SurasakNie/naodec/firmware/media_playback_controller/README.md

# Media Playback Controller Firmware

Arduino-IDE sketch for the NaoDec Media Playback Controller — an ESP32-S3-DevKitC-1
operator panel (rotary volume encoder + Play/Pause/Stop buttons + network status LED)
that sends OSC-over-UDP transport/volume commands to a Max/MSP patch. It carries no
audio, video, or LED data/power.

Firmware 3.x targets hardware **Rev 3.0**, which reaches the LAN over **wired
Ethernet** — U2, a WIZnet W5500 Lite SPI module — instead of Wi-Fi; see
[`NaoDec_Media_Playback_Controller_Rev3_Ethernet_Rationale.md`](../../NaoDec_Media_Playback_Controller_Rev3_Ethernet_Rationale.md)
for why.

**FW 3.1.x adds an optional Wi-Fi fallback** on the same Rev 3.0 hardware (no
schematic change). Wired Ethernet stays primary; if the Ethernet link drops and
stays down, and Wi-Fi credentials have been stored, the controller brings up a
Wi-Fi station and keeps sending OSC over it. Ethernet always wins — the moment
the cable link and DHCP lease return, the radio is switched back off. With no
credentials stored the board is wired-only, identical to FW 3.0.

The firmware version tracks the schematic revision it targets, with the minor
digit bumping for firmware feature releases on that hardware (FW 3.0.x =
Ethernet only; FW 3.1.x = Ethernet + Wi-Fi fallback; both ↔ Schematic Rev 3.0).
The patch digit is for firmware-only fixes on the same feature set:
- **FW 3.1.1** enables the ESP32's internal weak pull-ups on the encoder `A`/`B`
  pins (GPIO7/8), so those lines idle high even if a fitted KY-040 clone lacks
  its own onboard pull-ups. It touches no other pin.
- **FW 3.1.2** treats the three transport buttons as mutually exclusive: if two
  press edges arrive in the same debounce instant (impossible from a human on
  separate panel switches, but exactly what a GPIO9↔GPIO10 short produces), the
  event is rejected and logged as a `[FAULT]` instead of emitting a wrong
  transport command. See the Play/Pause note below — this is a guard and a
  diagnostic, **not** a substitute for clearing the short.

Full hardware assembly, wiring, network setup, and acceptance tests:
[`NaoDec_Media_Playback_Controller_Build_and_Max_Setup.md`](../../NaoDec_Media_Playback_Controller_Build_and_Max_Setup.md)
(Rev 3.0). Schematic: [`NaoDec_Media_Playback_Controller_Schematic_Rev3.0.html`](../../NaoDec_Media_Playback_Controller_Schematic_Rev3.0.html).

> **Note:** the Build & Max Setup document is still at Rev 3.0 and describes
> Ethernet-only behavior. The Wi-Fi fallback below is a firmware feature pending
> bench testing; that document will be revised to Rev 3.1 as a follow-up.

## Build requirements

- Arduino IDE with the **esp32 by Espressif Systems** board package **version
  3.0.0 or newer** (Boards Manager) — W5500 support lives in the core's `ETH.h`.
  If the build fails with `ETH_PHY_W5500` undeclared, the installed core is
  2.x; update it.
- **No third-party libraries.** The Wi-Fi fallback uses the core's own `WiFi.h`;
  the FW 1.x WiFiManager dependency is still gone and can be uninstalled.
- Board setting: **ESP32S3 Dev Module**, matching the ESP32-S3-DevKitC-1 board
  (N8R8 or N16R8 per the Build doc BOM).

Command-line compile check, if you use arduino-cli:

```bash
arduino-cli compile --fqbn esp32:esp32:esp32s3:CDCOnBoot=cdc firmware/media_playback_controller
```

## Network setup (Ethernet / DHCP reservation)

There is nothing to provision on the board — no SSID, no password, no captive
portal. The controller DHCPs over the wired link and the router hands it its
reserved address.

1. Connect the W5500's RJ45 to an ASUS RT-AX1800HP LAN port with the ~6 m Cat6
   run (W2 in the Build doc BOM).
2. Flash the firmware, open the Serial Monitor at 115200 baud, and type
   `STATUS`. Copy the `MAC (ETH)` line. **The Ethernet MAC is not the same as
   the old Wi-Fi MAC** — a DHCP reservation created for FW 1.x will not match
   this interface.
3. On the router, under LAN → DHCP Server → Manually Assigned IP, replace the
   old Wi-Fi-MAC entry with the Ethernet MAC at `192.168.50.114` (the `.11x`
   convention from Build doc Section 8).
4. Replug the cable (or power-cycle). `STATUS` should now show
   `IP address: 192.168.50.114`; confirm with `ping 192.168.50.114` and
   `ping naodec-playback.local` (mDNS).

The board is safe to boot with the cable unplugged: the status LED blinks at
~2 Hz until link + DHCP lease, then goes solid. If the reservation is missing,
the panel still works (OSC is outbound-only) — it just leases a pool address
(`192.168.50.100`–`199`), visible via `STATUS`.

## Wi-Fi fallback (optional, FW 3.1+)

Wired Ethernet stays primary and needs no provisioning. The Wi-Fi fallback is
opt-in — store credentials only if you want the panel to keep working when the
cable/router link is lost.

1. With the board flashed and the Serial Monitor open at 115200 baud, type
   `SETWIFI <ssid> <password>`. The SSID must not contain spaces; everything
   after the first space is taken as the password (so the password may contain
   spaces). Credentials are saved to NVS and never printed back or stored in the
   sketch.
2. `STATUS` now shows the stored SSID (never the password) and the **Wi-Fi MAC**,
   which differs from the Ethernet MAC. If you want the fallback to land on a
   fixed address too, add a *second* router DHCP reservation keyed to that Wi-Fi
   MAC (e.g. `192.168.50.115`). Otherwise it leases a pool address.
3. Behavior: only after Ethernet has been down continuously for ~15 s does the
   radio come up; the moment Ethernet regains its link + lease, the radio is
   switched back off. The OSC contract (addresses, port `9000`, target
   `192.168.50.2`) is identical on either interface.

To go back to wired-only, type `RESETWIFI` — it clears the stored credentials
and turns the radio off.

> mDNS (`naodec-playback.local`) is advertised for the interface active at boot;
> when running on the Wi-Fi fallback, reach the panel by its IP (from `STATUS`)
> if the `.local` name does not resolve. OSC itself always targets `MAX_HOST` by
> IP, so playback control is unaffected either way.

## Serial commands (USB, 115200 baud)

| Command | Effect |
|---|---|
| `STATUS` | Prints firmware version, active interface, Ethernet link state/speed + IP + MAC, Wi-Fi SSID/MAC/IP/RSSI (when credentials are stored), hostname, OSC target, current volume, and uptime. |
| `SETWIFI <ssid> <password>` | Stores Wi-Fi fallback credentials in NVS (SSID must not contain spaces; the rest of the line is the password). Enables the fallback path. |
| `RESETWIFI` | Clears the stored Wi-Fi credentials and turns the radio off — reverts to wired-only. |

## Configuration

`MAX_HOST` (`192.168.50.2`) and `OSC_PORT` (`9000`) are `#define`s at the top of
the `.ino`, matching the network plan in Build doc Section 8. These aren't
secrets — they're already published in that document. Wi-Fi credentials are the
one real secret, and they are never in the sketch: `SETWIFI` stores them in NVS
at runtime, so nothing sensitive is committed to this (public) repo.

The Ethernet-down grace period and the Wi-Fi retry cadence are the
`ETH_FALLBACK_MS` / `WIFI_RETRY_MS` `#define`s (both 15 s by default).

W5500 wiring is fixed by Schematic Rev 3.0 and mirrored by the `PIN_ETH_*`
defines:

| W5500 signal | ESP32-S3 GPIO |
|---|---|
| SCLK | 13 |
| MOSI | 14 |
| MISO | 15 |
| SCS (CS) | 16 |
| INT | 17 |
| RST | 18 |

`ETH_SPI_MHZ_W5500` (default 20 MHz) can be dropped to 10–16 if a jumper-wired
bench module shows SPI errors. If a bench build leaves INT unwired, polled mode
(`irq = -1`) requires esp32 core 3.1 or newer.

If the encoder direction comes out backwards on the bench (Build doc Section 9
troubleshooting table), flip `ENCODER_REVERSED` to `1` instead of re-wiring A/B.

If FUNC-05/06 show about half the expected step (ten detents move volume ~10
points instead of ~20), the fitted encoder emits two quadrature transitions per
detent rather than four — set `ENCODER_STEPS_PER_DETENT` to `2`.

`PIN_ENC_A`/`PIN_ENC_B` are configured `INPUT_PULLUP` (FW 3.1.1+) rather than
plain `INPUT`. The NEBDS-01's Schmitt push-pull output is unaffected by the
added internal pull-up; a bare KY-040 clone with no onboard CLK/DT pull-ups
now still idles high instead of floating. `R1`/`R2` (external 10 kOhm) remain
DNP by default per Build doc Section 3 — only populate them if encoder
misreads persist after this firmware change.

> This pull-up change is unrelated to Play/Pause/Stop: those buttons (GPIO9-11)
> were already `INPUT_PULLUP` and are untouched by FW 3.1.1.

### Play/Pause cross-trigger (one button fires two commands)

If pressing Play also fires Pause (or vice-versa), the root cause is a **short
between the adjacent button GPIOs — GPIO9 (Play) and GPIO10 (Pause)**, which sit
next to each other on the DevKitC-1 header. When bridged (solder whisker, stray
strand, pinched harness) both lines pull LOW together, so one physical press
reads as two. The audit ruled out the other layers:

- **Firmware button logic** debounces each pin independently — no cross-coupling.
- **Max test patch** routes `/transport/play` and `/transport/pause` through
  separate `OSC-route` objects with no cross-wire — verified in
  `TransportReceiveTest1.maxpat`.

So a firmware/patch change cannot *cure* a hard short — both pins read the same
value. What FW 3.1.2 does is **detect and contain** it: two simultaneous edges
are rejected with a `[FAULT] Simultaneous transport inputs …` log line that
names the suspect pins, turning a confusing phantom-Pause into an obvious,
logged fault. The fix itself is hardware: power off and run the **GPIO9↔GPIO10
continuity check** in Build doc Section 10 (≈0 Ω = header/PCB bridge; ≈200 Ω =
panel-side harness short; ≈20 kΩ = healthy).

> **Max patch note:** the bundled `TransportReceiveTest1.maxpat` had its Stop
> route mis-cased as `/transport/Stop/`, which never matched the firmware's
> lowercase `/transport/stop`; it is corrected to `/transport/stop/` so all four
> routes match. (Unrelated to the Play/Pause short, but found in the same audit.)

## Status LED

| LED state | Meaning |
|---|---|
| Solid on | Ethernet link up with a DHCP lease — normal operation |
| Mostly on, brief off-blip every ~2 s | Running on Wi-Fi fallback — panel works, but the wired link is down and needs attention |
| Blinking ~2 Hz | No network on either interface (check cable, router port, DHCP; Wi-Fi not connected) |
| Off | No power (or firmware fault) |

## Validating before installation

This firmware implements the behavior table in Build doc Section 6 and the OSC
contract in Section 7. Before calling a built unit ready, run the full
acceptance test list in Section 11 — the network tests are exercised with the
Ethernet cable (unplug/replug) rather than the router's Wi-Fi radio — and fill
out the Section 12 commissioning record, including the `FW_VERSION` string this
firmware prints at boot as the "Firmware version" field.
