SurasakNie/naodec/Paint_Comparison_Maxzo_RustTech_vs_JBP_SmartGlaze.md

# Paint Comparison for Wood Work: Maxzo Rust Tech 2IN1 #8300 vs. JBP Smart Glaze (Ultra Gloss Enamel & 2IN1)

Reference notes comparing three commercially available oil/alkyd-type coatings for painting wood
(and mixed wood + metal builds), with cautions specific to wood application.

## Products covered

1. **Maxzo Rust Tech 2IN1 #8300** — matte black, combines anti-rust primer + topcoat in one product.
   Primary use case is metal (steel, galvanized steel, zinc-plated steel, aluminum, stainless steel);
   the label also lists plywood, wood siding board, and all types of artificial/composite wood as
   compatible surfaces — solid/hardwood is not listed.
2. **JBP Smart Glaze Ultra Gloss Enamel** — oil-based alkyd resin gloss enamel, topcoat only (no
   built-in primer). Labeled for both wood and metal (doors, windows, furniture, machinery).
3. **JBP Smart Glaze 2IN1** — acrylic-resin based, combines anti-rust primer + topcoat in one
   product, explicitly labeled for metal, non-metal, and wood surfaces, interior and exterior.

## Comparison table

| Consideration | Maxzo Rust Tech 2IN1 #8300 (matte) | JBP Smart Glaze Ultra Gloss (gloss) | JBP Smart Glaze 2IN1 (gloss) |
|---|---|---|---|
| Formula type | 2-in-1 anti-rust primer + topcoat | Topcoat only (alkyd) | 2-in-1 anti-rust primer + topcoat (acrylic) |
| Labeled for use on wood | ❌ (primary formula target is metal) | ✅ (wood & metal: doors, furniture) | ✅ (metal, non-metal, and wood — explicit) |
| Usable on plywood / siding board / composite wood | ✅ | ✅ | ✅ |
| Usable on solid/hardwood per label | ❌ (not listed — test a small area first) | ✅ | ✅ |
| Built-in primer (no separate primer coat needed) | ✅ | ❌ (bare wood should be primed/sealed first) | ✅ |
| Rated for exterior use (sun/rain exposure) | ✅ | ✅ | ✅ |
| Impact / scratch resistance per label | ✅ (explicitly stated) | ⚠️ (not explicitly stated, but typical for alkyd gloss) | ⚠️ (not explicitly stated) |
| Anti-fungal / anti-algae | ⚠️ (not stated) | ✅ (explicitly stated) | ⚠️ (not stated) |
| Lead/mercury-free (stated on label) | ⚠️ (not stated) | ✅ (explicitly stated) | ⚠️ (not stated) |
| Finish hides surface imperfections in wood | ✅ (matte) | ❌ (gloss shows flaws — sand smooth first) | ❌ (gloss shows flaws — sand smooth first) |
| Fewer work steps / faster overall job | ✅ (single coat system) | ❌ (needs separate primer + topcoat, ≥2–3 passes) | ✅ (single coat system) |
| Fast drying | ✅ (headline feature) | ❌ (surface dry 30 min–4 hr / recoat 4–8 hr / full cure 48 hr+) | ⚠️ ("fast drying" claimed; touch-dry ~30 min, but recoat still 4–8 hr) |
| Required thinner | AAA thinner only (never turpentine/mineral spirit substitute) | JBP T-317 or AAA thinner | JBP T-317 or AAA thinner |
| Coverage per gallon per coat | ⚠️ (no confirmed figure found) | ✅ 30–40 m² | ✅ 30–40 m² |
| Long-term gloss/color retention (as a selling point) | ❌ (matte finish, not the focus) | ✅ (headline feature of this line) | ⚠️ (glossy, but retention isn't emphasized as strongly) |
| Best fit for mixed wood + metal builds in one pass | ✅ | ❌ | ✅✅ (only 2-in-1 in this table explicitly rated for wood) |

Legend: ✅ suitable/confirmed · ❌ not suitable/not confirmed for this use · ⚠️ usable with caveats, or unconfirmed by the manufacturer listing.

## Cautions when painting wood

- **Maxzo Rust Tech** is formulated first for rust prevention on metal. Its wood compatibility on
  the label is limited to plywood/siding/composite wood — not solid wood. The rigid rust-inhibitive
  film is not designed to flex with wood's moisture-driven expansion/contraction, so it may be more
  prone to cracking along the grain on solid wood over time. Test on a small area first.
- **JBP Smart Glaze Ultra Gloss Enamel** is a topcoat only — bare wood should get a wood primer/
  sealer coat first, otherwise the oil-based enamel absorbs unevenly into porous wood (knots, end
  grain), producing a patchy sheen and wasting material.
- **Drying times matter for scheduling.** JBP Ultra Gloss: touch-dry in 30 min–4 hr, recoat window
  4–8 hr, full/hard cure 48 hr+. Don't load or stack painted pieces before full cure, and protect
  the work from dust, insects, and rain throughout the cure period. Recoating outside the 4–8 hr
  window (i.e., after the film has hardened too much) needs a light sanding pass first for proper
  intercoat adhesion; recoating too early (before the lower coat has released enough solvent) risks
  wrinkling/lifting.
- **Use only the manufacturer-specified thinner** — Maxzo requires AAA thinner and explicitly warns
  against turpentine; using the wrong solvent affects film adhesion and finish.
- **Gloss vs. matte surface prep**: gloss finishes (both JBP products) show surface defects clearly,
  so sand and fill wood before coating. Matte (Maxzo) is more forgiving of surface texture.
- **Don't casually layer products from different lines** (e.g., a Maxzo matte base under a JBP gloss
  topcoat) without a test patch — different alkyd/acrylic formulations and solvent strengths can
  cause poor intercoat adhesion or wrinkling if recoat timing isn't respected.
- **Solvent-based safety**: all three products are flammable while wet, need good ventilation, and
  require PPE (gloves, respirator) during application. Oil-soaked rags carry a spontaneous
  combustion risk — lay them flat to dry outdoors or submerge in water before disposal; never bunch
  them into a trash bin.
- **Label mix-up risk**: JBP sells both "Smart Glaze Ultra Gloss Enamel" (topcoat only) and "Smart
  Glaze 2IN1" (primer + topcoat) under similar names — confirm "2IN1" is on the label if a
  self-priming product is what's needed.
- Neither Maxzo nor JBP 2IN1 states anti-fungal/anti-algae or lead/mercury-free properties on their
  listings (unlike JBP Ultra Gloss, which states both) — verify on the physical can label if this
  matters for the application (e.g., children's furniture).

## Sources

- [Maxzo Rust Tech (MATT) — chosanguan.com](https://chosanguan.com/products/588-maxzo-rust-tech-matt-แมกโซ่-รัสท์เทค-สีทาเหล็ก-2-in-1.html)
- [TDS Maxzo Rust Tech 2 IN 1 — srrpaint.co.th (PDF)](https://www.srrpaint.co.th/filesdirectserver/itp1/98c8b34845583eba/TDS-Rusttech-DATA-mattz-z687914991456.pdf)
- [JBP Smart Glaze Ultra Gloss Enamel — jbp.co.th](https://jbp.co.th/product/jbp-smart-glaze/)
- [JBP Smart Glaze Enamel Paint 2IN1 — jbp.co.th](https://jbp.co.th/product/jbp-smart-glaze-enamel-paint-2in1/)
- [JBP Smart Glaze 2IN1 — Thaiwatsadu](https://www.thaiwatsadu.com/th/product/สีทับหน้าและรองพื้นกันสนิม-ชนิดเงา-JBP-รุ่น-SMART-GLAZE-2IN1-ขนาด-1-แกลลอน-สีเงิน-G7114-60418537)
- [JBP Smart Glaze 2IN1 — HomePro](https://www.homepro.co.th/p/1272393)
- [JBP Smart Glaze Ultra Gloss Enamel — Kasem Paint Depot](https://www.kasempaintdepot.com/product-page/ส-น-ำม-นเจบ-พ-สมาร-ทเกรซ-jbp-smart-glaze-แกลลอน)
