SurasakNie/naodec/NaoDec_Build_Step7_Edge_Covers.md

# NaoDec Build — Step 7: Edge Covers

**Revision:** 1.0
**Date:** 2026-07-14
**Status:** Drafted from the author's outline + decision 9⑤. Cover material, profile, and fixing method are TBD (see Open Items).

[← Back to Build Work Instructions](NaoDec_Build_Work_Instructions.md) · Previous: [Step 6 — Move-In](NaoDec_Build_Step6_Move_In.md) · Next: [Step 8 — Controller Unit Hookup](NaoDec_Build_Step8_Controller_Unit_Hookup.md)

## Purpose

Fit the **25 external edge covers** over the 25 lettered joints, closing out the structure's outside seams. The 5 ground-resting edges get no cover.

## Quick Reference

| Fact | Value |
|---|---|
| Covers | **25 pieces** — one per lettered joint (A–Z, no `W`) |
| No cover on | the 5 unlettered ground edges (`f7`–`f11` base edges) |
| Per joint, on that edge | 2 hinges (Step 2) + internal LED strip (Step 4) + on joint M a speaker (Step 5) + this cover |
| Door joints | A, B, K, L — covers here must not block the door mechanism |
| Top joints | U, V, X, Y, Z — overhead work |

The 25 lettered joints (from the marking guides): A B C D E F G H I J K L M N O P Q R S T U V X Y Z.

## 7.1 Fit the covers

1. Fit each cover over the **outside** of its lettered joint — the LED strips run on the inside (Step 4), so covers and strips are on opposite faces of the edge.
2. Each cover must **clear the 2 hinges** on that joint and any speaker/bracket hardware (joint M) — profile has to bridge or notch around them (Open Item #1).
3. Work bottom-up so offcuts/tools don't fall onto finished lower work; leave the **5 top joints (U, V, X, Y, Z) for last** — overhead work.
4. **Door joints A, B, K, L:** fit so the door still opens per the Step 2 mechanism decision — a cover spanning the door's hinge line or latch side can lock it shut (Open Item #3).

> The covers hide the assembly letters. Since the marking system exists for teardown/re-assembly, record each cover's joint letter **on the cover itself** (inside face) or keep a teardown map, so letters stay findable later (Open Item #2).

## Safety

- Overhead work for the top joints — positive fastening, nothing relying on friction over the occupant.
- Ladder work inside/outside the closed structure; the chair and equipment are now in place (Step 6), so protect them below the work.

## Release Gate

| Gate | Required Result |
|---|---|
| Count | 25 covers fitted, one per lettered joint; ground edges bare |
| Clearance | Each cover clears its hinges + hardware; no fabric pinch |
| Door | Door joints' covers do not impede opening/closing from inside |
| Teardown | Joint letters recorded on/with each cover |

## Open Items

1. **Cover material / profile / fixing method** — screwed, clipped, magnetic, snap-fit? Must span/notch the 2 hinges (+ speaker on M). TBD.
2. **Removability for teardown** — covers + hinges must come apart for repeat assembly (index Open Item #5); letters stay findable.
3. **Door-edge covers vs. door swing** — depends on the door mechanism (Step 2 Open Item #1).
4. **Function of the covers** — purely cosmetic edge trim, or do they also seal the fabric edges against light leak / weather? Not stated; affects material choice.

---

[← Back to Build Work Instructions](NaoDec_Build_Work_Instructions.md) · Previous: [Step 6 — Move-In](NaoDec_Build_Step6_Move_In.md) · Next: [Step 8 — Controller Unit Hookup](NaoDec_Build_Step8_Controller_Unit_Hookup.md)
