SurasakNie/naodec/(commit log)

2026-04-24 Initial NaoDec repo: wiring and schematics + auto-index workflow
2026-04-28 feat: publish Rev1.2 / Rev1.1 / Rev1.6, remove Rev1.1 / Rev1.0 / Rev1.5
    Replaces NaoDec_3D_Internal_Edges_LED_Mapping_Rev1.1 → Rev1.2,
    NaoDec_3D_Vertex_LED_Mapping_Rev1.0 → Rev1.1,
    NaoDec_WS2815_LED_Controller_Rev1.5 → Rev1.6.
    Simple_WS2815_Controller_Rev_1.0 unchanged. The auto-index workflow
    will regenerate index.html on push.
2026-05-15 Rename NaoDec Scent Controller - Schematic Rev 1.0.html to NaoDec_Scent-Controller_Schematic_Rev1.0.html
2026-06-16 Add Series Coil / Electromagnet subsystem docs (#2)
    Adds NaoDec_Series_Coil_Build_Rev1.0.html (self-contained page with two
    inline-SVG wiring figures, electrical tables, BOM, and safety checklist) and a
    matching README section with Mermaid diagrams.
    Key facts captured: on DC the 60-coil string is a ~3 ohm resistive near-short
    (no current limiter) drawing ~3-4 A / ~47 W; at ~4 A common JSTs are over
    rating so VH/Anderson + a 3-5 A fuse + a current-limited supply are needed; the
    crystal core is non-magnetic so the field stays weak (~28 AT/coil).
    https://claude.ai/code/session_01WWxNKYQzr3pKRn3qgcNeEq
2026-06-16 Archive Scent Controller schematic Rev1.0 (#3)
    Moves the superseded NaoDec_Scent_Controller_Schematic_Rev1.0.html into
    Archived/ (Rev2.0 remains the current top-level version). Pure file move;
    index.html regenerates on main and drops Rev1.0 from the index.
    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
2026-06-17 Add Controller Box Configurations diagram Rev1.0
    Interactive HTML showing both enclosure options (electrical DIN-rail box
    and PC case + ATX PSU) with component layout, power routing, mid-strip
    injection wiring, and a comparison table.
    https://claude.ai/code/session_01X5VjzeCp9amFkY88mgiwpq
2026-06-17 Audit and correct power calculations in controller box configs (Rev1.1)
    Seven calculation errors corrected vs Rev1.0:
    - Cable resistance was off by 3.28× (Ω/1000ft used as mΩ/m)
    - Strip #1 18AWG 20m V-drop: 230mV → 754mV (strip input 11.77→11.25V)
    - Edge head-feed 12AWG 4m V-drop: 53mV → 175mV
    - In-strip injection drops: 329mV first-half corrected to 188mV; end-voltage
    labelled as estimate (typ. 60mΩ/m trace — measure to confirm)
    - Removed fabricated "53.4A worst-case" (no basis in source schematics)
    - Edges total: 26.6A (15.8mA/px) → 25.2A (15mA/px per source schematic)
    - 12V rail total: 27.3/28.7A (inconsistent) → 27.1A everywhere
    - Scent ESP current: 0.58A → 0.40A; tot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
2026-06-17 Add full power & controller box report (Rev 1.0)
    Consolidates all audited figures into one reference document:
    - Device-by-device power inventory (verified against both schematics)
    - PSU requirements for all 4 rails with margins
    - Config 1 (DIN-rail enclosure) and Config 2 (ATX case) specifications
    - Cable voltage-drop analysis with corrected mΩ/m resistances
    - Mid-strip injection layout for 6 edge strips
    - ATX PSU shortlist (10 units)
    - Full audit findings table (13 corrections, Rev1.0 → Rev1.1)
    - Open items requiring physical measurement or user decision
    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
2026-06-17 Add html-schematic org skill (v4.0.0) as a project skill
    Vendor the Hubble Engineering html-schematic skill into
    .claude/skills/html-schematic/ so /html-schematic is available to Claude
    Code sessions on this repo — which is built around the exact
    SVG/zoom/pan/tooltip HTML schematics this skill generates.
    Contents: SKILL.md, reference/ (conventions, tables, tokens,
    validator-spec, 8 theme palettes), snippets/, skeleton.html.
    Intentionally omits the skill's bundled .claude/ packaging files
    (launch.json, settings.local.json): they are the author's local Windows
    build/zip tooling with hardcoded personal paths, are not read by Claude
    Code from inside a nested skill folder, and settings.local.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
2026-06-17 Rename Series Coil build to Rev 0 — pre-release
    Demote NaoDec_Series_Coil_Build from Rev 1.0 to Rev 0 (pre-release):
    rename the HTML file and update its title/subtitle/footer, plus the
    README repo tree, write-up link, and revisions table, and the
    auto-index entry.
    Add CLAUDE.md recording the pre-release status and project conventions
    (filename versioning, auto-generated index, isolated power rails).
    Claude-Session: https://claude.ai/code/session_01SA58jxHXGFS1beMYw1qYmc
2026-06-17 Add project CLAUDE.md with Wire Assignment Table (Dark Teal palette)
    Locks the html-schematic skill's VR9 net-color allocation to NaoDec's
    real harness: maps wdata..wdata7 to CH1..CH7 using the existing
    Rev-series Dark Teal hex palette, so skill-generated/revised schematics
    stay color-consistent with the current rig docs.
    Net-IDs (CH1..CH7) and per-channel hex are taken from
    NaoDec_WS2815_LED_Controller_Rev1.6.html; the channel/GPIO/strip/LED
    mapping is from the README. Power-rail tokens documented for reference.
    The table is in the exact 3-column format the skill's validator parses
    under a "Wire Assignment Table" heading.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
2026-06-17 Add CC/CV buck (~3 A) as recommended current limiter
    Document a CC/CV buck converter with the constant-current limit set to
    ~3 A as the cheap, enclosure-friendly hard current limit for the series-
    coil near-short: add a BOM row, a "Recommended supply" option, and a
    mention in the safety checklist. Note that into the ~3 Ω load it sits in
    CC and the output self-settles to ~9 V.
    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
2026-06-17 Fix VR9/VR7 finding: tag backup-ground wires as a ground rail (Rev1.6)
    The 7 "Head BI -> GND" backup-input polylines used a custom `.wbkp-gnd`
    class the html-schematic validator doesn't recognize as a rail, which
    tripped VR9 (net-color table) and VR7 (legend strip). Prepend the
    recognized `wgnd` rail class: class="wgnd wbkp-gnd".
    Zero visual change: `.wbkp-gnd` is declared after `.wgnd`, so its
    stroke-width:2 still wins the cascade; the validator now reads the first
    class `wgnd` as a ground rail. Backup-ground semantics stay intact via
    the retained `.wbkp-gnd` class and each wire's data-info. Also makes
    these wires pick up print-mode ground coloring.
    No revision bump or file rename: this i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
2026-06-17 Reconcile PR #4 (CC buck / input fuse / paralleled-SM) onto Rev 0 — pre-release
    Fold the chosen power-protection design from PR #4 into the renamed Series
    Coil document under our Rev 0 — pre-release identity. PR #4 kept Rev 1.0;
    this keeps the rename and the Rev 0 — pre-release labels instead.
    - BOM: JST SM connectors (both pins paralleled), 12 V PSU feeding the buck,
    CC/CV buck module (XL4015, CC ~3 A) as the current limiter, input-side
    fuse re-justified (buck CC is regulation not fault protection; bucks fail
    shorted).
    - New "Recommended solution" section + "why this works" callout; safety
    checklist updated to the buck-based solution.
    - Mirror the same into README (BOM, elect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
2026-06-17 Show the XL4015 CC/CV buck inline in Figure 1 (loop topology)
    Redraw the Series Coil topology diagram as PSU → fuse → CC/CV buck
    (XL4015, CC ~3 A) → 20 groups → 6 m return, so the figure matches the
    recommended solution. The buck is now drawn as the current limiter and
    the caption no longer claims "no current-limiting element other than
    wire resistance and the supply."
    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
2026-06-17 Spell out fuse placement: before the XL4015, not after
    Approved design decision — the input-side fuse is the only position that
    contains input-stage and buck-internal shorts (input cap, FET-to-ground,
    shorted output cap); an output-side fuse is blind to them. Make the
    before-not-after rationale explicit in the Recommended solution section.
    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
2026-06-19 Series Coil: record bench-verified XL4015 operating point (11.68 V / 2.75 A)
    The XL4015 CC/CV buck is already documented as the current limiter. Add the
    measured bench result alongside the predicted numbers: the string runs at
    11.68 V / 2.75 A (~32 W) at the buck output, implying a real loop of ~4.3 ohm
    (a little above the ~3 ohm estimate), so current settles just under the 3 A cap
    — sitting at the CV/CC knee rather than deep in CC.
    Updates the HTML recommended-solution and BOM sections plus the README BOM and
    electrical-summary tables; refreshes the in-page date. Connector and other
    guidance unchanged.
    Claude-Session: https://cla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
2026-06-19 Add Media Playback Controller schematic Rev 1.0
2026-06-19 Update PSU connection to 5V pin instead of USB-C
    Changed Media Playback Controller schematic to route PSU power directly to the
    5V pin rather than through USB-C, improving clarity on the intended power path.
    Claude-Session: https://claude.ai/code/session_01EqEs5bzcng2fjiRZzaTxwB
2026-06-19 Add Rev1.3: Series Coil Circuit display layer
    - New Coil toggle in Display panel: red positive daisy-chain (0→v1→…→v20) and dark-blue negative return (v20→v16→v15→v6→v5→v1→0)
    - Shared-edge parallel lines: red stays on edge, blue offset beside it
    - Coil view forces vertex node labels visible
    - Summary moved to its own left-panel tab (Routing · Summary · Revisions)
    - Rev1.2 kept live alongside Rev1.3; both listed in index.html and README.md
2026-06-19 Add Vertex series coil schematic
2026-06-19 Fix schematic UTF-8 encoding
2026-07-01 Update media playback encoder module schematic
2026-07-01 Align Media Playback Controller network setup with real ASUS LAN
    Replace placeholder Max/controller IPs with the actual NaoDec router
    config: gateway 192.168.50.1, Mac Mini static 192.168.50.2, and
    192.168.50.114 reserved for this controller per the .11x ESP32
    addressing convention. Credentials are referenced, not embedded.
2026-07-01 Document KY-040 encoder replacement option
2026-07-02 Fix cross-references and metadata for Media Playback Controller docs
    - Build doc: correct schematic filename reference (was missing NaoDec_
    prefix, 404 on Pages), bump to Rev 1.1 / 2026-07-02 with a change note
    for the network alignment
    - Schematic: note 1 now points to build doc section 7 (OSC contract),
    not the wrong "Section 2"
    - README: list both Media Playback Controller files in the repo tree
2026-07-02 Rev 2.0: harden Media Playback Controller design
    New NaoDec_Media_Playback_Controller_Schematic_Rev2.0.html (Rev 1.0
    kept in place for reference) and build doc bumped to Rev 2.0:
    - LED1 Wi-Fi status indicator on GPIO12 via R11 330 ohm
    (solid = connected, blink = reconnecting, off = no power)
    - R6-R10 100 ohm series resistors on all off-board GPIO lines
    (ESD/short protection + edge damping)
    - H1 keyed JST-XH 5-pin encoder connector (mis-plug-proof);
    H2-H5 2-pin for buttons and LED
    - Encoder shaft/frame-to-GND continuity added to build steps,
    electrical checks (new ELEC-03), and acceptance tests (FUNC-09)
    - USB-C cable spec tightened to quality cable <= 1 m
    README tree and index.html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
2026-07-02 Rev 2.1: require U1 co-located with operator panel; label R/C designators
    - Build doc: new Placement Requirement (Section 1) explaining why U1 must
    mount inside the operator panel enclosure rather than near the router —
    the panel wiring is unbuffered 3.3V logic rated for ~0.5 m runs, and
    Wi-Fi (not router proximity) already covers the long distance leg.
    Reinforced in the build steps and ASUS router setup section.
    - Schematic Rev 2.0: every R/C component box now shows its designator
    before the value (e.g. "R6 · 100", "C3 · 100n") instead of value only.
    Boxes were resized to fit and all connecting wire endpoints were
    updated to match; verified no clearance violations or text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
2026-07-02 Rev 2.2: document R1/R2/C1/C2 fallback values; add DOCX copy
    - Build doc: new "R1/R2/C1/C2 Fallback (Troubleshooting Reference)"
    section under the encoder documentation. Records that these four
    parts stay unpopulated by default on both encoder modules, and are
    only fitted (10 kOhm / 100 nF, matching the button RC values) if the
    KY-040 shows encoder misreads that firmware filtering doesn't resolve.
    - Add NaoDec_Media_Playback_Controller_Build_and_Max_Setup.docx, a Word
    rendering of the build doc for readers who prefer/require .docx.
    Generated with pandoc; tables, headings, and code blocks verified.
    - README and index.html list the new .docx.
2026-07-05 Add ESP32-S3 firmware for the Media Playback Controller
    Implements the Build_and_Max_Setup.md (Rev 2.2) spec: rotary encoder ->
    volume OSC, three transport buttons, Wi-Fi status LED, NVS-persisted
    volume, and OSC-over-UDP to Max/MSP. Architecture and coding conventions
    (WiFiManager captive-portal provisioning, RESETWIFI serial command,
    tagged Serial logging, boot-safe output state) are adapted from the
    existing Aroma/Scent Controller firmware.
    Claude-Session: https://claude.ai/code/session_011PV83pLjkTpQP19wt9Sddp
2026-07-07 Bump Media Playback Controller schematic to Rev2.2
    Aligns the schematic file with the build doc, which was already at
    Revision 2.2 while the schematic HTML itself never advanced past 2.0.
    Placeholder metadata bump only (title, title-block, revision history) —
    no electrical/BOM changes — to give a clean starting point for the
    upcoming PCB layout project. Rev2.0 moves to Archived/ per repo
    convention; Rev1.0 stays at top level as previously documented.
2026-07-07 Harden Media Playback Controller firmware from post-merge audit
    Fixes found in a two-pass audit of the merged firmware:
    - HIGH: bound the WiFiManager captive portal with a 180 s timeout so a
    power-up while the router is down no longer strands the panel in the
    portal forever; autoConnect() now returns and the device restarts to
    retry the saved network (fixes the NET-04 reboot case).
    - MEDIUM: sample the button pins in begin() so a button held or a harness
    shorted at boot no longer registers a phantom press and sends a transport
    command (fixes the FUNC-08 boot rule).
    - MEDIUM: blink the status LED via a Ticker while autoConnect() blocks, so a
    dark LED reliably means "no power / fa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
2026-07-08 Copy media_playback_controller firmware from main
    Brings the firmware/media_playback_controller/ directory (Arduino sketch
    + README) onto the schematic branch so hardware and firmware live together
    for the PCB work.
    Claude-Session: https://claude.ai/code/session_01CiVJH3cCEGaGJA8n8yUTPq
2026-07-08 Rev 3.0: add W5500 Lite Ethernet module to Media Playback schematic
    Adds a wired-Ethernet path so the ESP32 can sit in the chair-side panel
    (short encoder/button runs) and reach the router over Cat6 instead of a
    long unbuffered signal harness.
    - New U2 (WIZnet W5500 Lite) placed below PSU1; SPI + power wired straight
    to eight new pins on U1's left edge (GPIO13-18 SCLK/MOSI/MISO/SCS/INT/RST,
    plus 3V3 and GND). No wire crossings in the new channel.
    - New C6 100 nF decoupling shunt across the W5500 3V3/GND.
    - PSU1 GND return rerouted down the far-left rail so the SPI channel stays
    clear.
    - Legend gains an SPI entry (SPI bus on the free wdata7 gold class); BOM adds
    U2, C6 and W2 (Cat6 c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
2026-07-08 Document Rev 3.0 Ethernet change rationale
    Add NaoDec_Media_Playback_Controller_Rev3_Ethernet_Rationale.md explaining
    the 6 m unbuffered-signal-wire problem, the options considered (ESP32 in
    ATX case, Wi-Fi through a metal case, wired Ethernet), why Rev 3.0 moves to
    a W5500 wired-Ethernet link, and the new components (U2 W5500, C6, W2 Cat6)
    with the SPI wiring and power notes. Linked from README tree and index.html.
    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
2026-07-09 firmware: swap Wi-Fi for W5500 Ethernet (FW 3.0.0, hardware Rev 3.0)
    Complete the firmware follow-up from the Rev 3.0 Ethernet rationale doc:
    the network layer moves from Wi-Fi (WiFiManager captive portal) to the
    esp32 core's W5500 driver (ETH.h, SPI on GPIO13-18), keeping the same
    OSC/UDP contract, IP scheme, and encoder/button/LED logic.
    - Requires esp32 Arduino core >= 3.0.0; drops WiFiManager (no third-party
    libraries remain)
    - DHCP only; safe to boot with the cable unplugged (LED blinks until
    link + lease, no restart loop); driver re-leases on link restore, so
    maintainWifi()-style reconnect logic is gone
    - OSC sends are guarded while offline; "no OSC on boot" rule unchanged
    - STA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
2026-07-09 docs: update Media Playback Controller docs for Rev 3.0 / FW 3.0.0
    - Build & Max Setup doc -> Rev 3.0: U2 W5500 Lite + C6 + W2 Cat6 in the
    BOM, GPIO13-18 SPI rows and a U2 harness table in the pin map, wired
    build steps and electrical checks, Ethernet DHCP firmware behavior
    (no provisioning, no credentials), router setup re-keyed to the
    Ethernet MAC from STATUS, acceptance tests remapped (NET-01/04, new
    NET-05 cold-boot-unplugged, FUNC-09, SYS-01 wired link)
    - firmware README: core >= 3.0.0 requirement, Ethernet/DHCP-reservation
    setup replacing the captive-portal section, STATUS-only command
    table, PIN_ETH_* wiring table, fixed the stale Rev 2.0 schematic link
    - Rev 3 rationale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
2026-07-09 docs: regenerate Build & Max Setup docx for Rev 3.0, add firmware appendix
    Rebuild the .docx from the same template/style as the user's reference
    Rev 2.2 copy (Document Control title page, dark-navy header tables,
    bulleted revision history) instead of the old python-docx "Build & Setup
    Manual" template, so the binary doc matches the Rev 3.0 .md: W5500/C6/W2
    BOM rows, GPIO13-18 pin map plus a new W5500 SPI harness table and
    subsection, renumbered build/router-setup steps, Ethernet firmware
    behavior, remapped acceptance tests, and the Rev 3.0 revision-history
    entry. Also appends a new "14. Firmware Source" section with the full
    current media_playback_controller.ino (FW 3.0.0) as a code listing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
2026-07-10 firmware: add Wi-Fi fallback (FW 3.1.0, hardware Rev 3.0)
    Rename the sketch to media_playback_controller_R3.1.ino and add an optional
    Wi-Fi fallback while keeping wired Ethernet primary.
    - Ethernet stays the primary interface; Wi-Fi is brought up only after the
    Ethernet link has been down continuously for ~15 s, and is switched back off
    the moment Ethernet regains link + DHCP lease. Only one interface carries
    traffic at a time, so the OSC senders never face an ambiguous route.
    - Credentials are provisioned over USB serial (SETWIFI <ssid> <password>) and
    stored in NVS, never in the sketch — nothing secret is committed. RESETWIFI
    clears them and reverts to wired-only. With no cred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
    [media_playback_controller_R3.1.ino]
2026-07-10 Add README for Scent Controller firmware
    Document the Scent_controller_web_R2.0.ino sketch: Waveshare
    ESP32-S3-Relay-6CH driving 4x JY-M27AO atomizers, the three command
    entry points (web UI/WebSocket, UDP for Max/MSP, USB Serial), Wi-Fi
    captive-portal setup, command reference, pin map, and network config.
    Claude-Session: https://claude.ai/code/session_01T7FLopDJUSD5LaQU9RRJbX
2026-07-10 docs: Build & Max Setup Rev 3.1 — Quick Reference table, FW 3.1.0 alignment
    Add a Quick Reference table ahead of Section 1 in both the .md and a new
    Rev 3.1 .docx: all four OSC addresses (/transport/play|pause|stop and
    /volume for the encoder), mDNS hostname, UDP port, Max host IP, and the
    controller's reserved IP. Align Section 6 and the docx firmware-source
    appendix with firmware 3.1.0 (optional SETWIFI Wi-Fi fallback; Ethernet
    primary), including the three-state status-LED behavior. Archive the
    superseded Rev 3.0 docx. Documentation only — hardware stays Rev 3.0.
    Claude-Session: https://claude.ai/code/session_01Sh6rnhfzbBg3Rr87rZ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
2026-07-12 Add dodecahedron face edge-letter marking guide
    11 built pentagon faces (bottom face left unbuilt) each get a labeled
    pentagon diagram showing the edge-letter marks from the build table, so
    on-site assembly/tear-down only requires matching identical letters.
    Includes an edge-position legend, Door/Top face badges, ground-hatch
    styling for the 5 unlettered edges resting on the platform, and an
    auto-derived cross-reference table with a runtime self-check that every
    letter pairs exactly twice.
    Wires up index.html and README.md by hand per repo convention for
    feature-branch doc additions.
2026-07-12 Add pure structure-framework page (vertices/edges/faces only)
    Extracts the geometric skeleton from NaoDec_3D_Vertex_and_Edges_LED_
    Mapping_Rev1.3.html into its own interactive 3D viewer: 20 vertices
    (v1-v20, ring-grouped), 30 structural edges, and 12 faces (f1-f12),
    with the same rotate/pan/zoom/preset-view controls and theme switcher.
    Drops everything LED/electrical-specific (C1-C6 edge circuits, vertex
    LED daisy-chain, series coil circuit, node 0/power-in) and the User
    POV/chair prop, none of which are part of the dodecahedron's structure.
    Face f12 (bottom) is flagged as unbuilt (dashed outline + label),
    matching CLAUDE.md and the face-marking guide added earlier.
    Cross-links this, the L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
2026-07-12 Structure framework: hide vertices by default, letter the edges; fix review findings
    Per user request, vertices/node numbers are now hidden by default (Vertices
    and Node # toggles still available for anyone who wants them back) and the
    30 structural edges each render a fresh per-diagram reference letter (A-Z,
    then AA-AD for the last 4), with a matching reference list in the left
    panel. These letters are independent of the physical door/build letters in
    NaoDec_Face_Edge_Marking_Rev1.0.html -- the two numbering schemes have no
    confirmed correspondence, so the UI says so in both the Structure tab and
    the Summary tab rather than implying one.
    Also fixes two regressions an independent review cau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
2026-07-12 docs: describe the structure-framework page's new default view in README
    Vertices/nodes hidden by default, edges shown with fresh per-diagram
    A-Z/AA-AD reference letters -- update the Physical Structure section
    to match instead of the stale vertex/face-only description.
2026-07-12 Add alternate interactive design for face edge marking guide
    NaoDec_Face_Edge_Marking_Interactive_Rev1.0.html covers the same
    11-face/edge-letter marking data as NaoDec_Face_Edge_Marking_Rev1.0.html,
    with a different visual design and a joint-highlight dropdown instead of
    a static-only reference table. Kept as a separate file alongside the
    existing guide rather than replacing it.
    Claude-Session: https://claude.ai/code/session_01A3D747rE5dugK9vw1Ctwak
2026-07-12 Rename interactive marking header; drop face-ID cross-ref note
    - NaoDec_Face_Edge_Marking_Interactive_Rev1.0.html: retitle header (and
    <title>) from "NaoDec Structure Framework" to match the file name.
    - NaoDec_Face_Edge_Marking_Rev1.0.html: remove the note tying the build
    face numbers to the f1–f12 IDs in the LED mapping doc; that
    correspondence isn't established, so drop it for now.
    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
2026-07-12 Structure framework: physical assembly letters on the 30 edges
    Replace the synthetic per-diagram letters (A-Z, AA-AD) with the real
    assembly letters from the Face Edge Marking guides. The marking-face to
    3D-face correspondence (FACE_MAP) is pinned by the anchors f1 = Top
    (= F10) and f11 = Door (= F05, newly labeled); under the marking docs'
    viewed-from-outside counter-clockwise convention the orientation-
    preserving isomorphism between the two face-adjacency graphs is unique.
    Letters are derived at runtime from the embedded marking table by
    intersecting mapped face vertex sets, with a self-check banner if the
    data ever drifts (25 letters on 25 distinct edges + 5 OPEN base edges
    covering all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
2026-07-13 Structure framework: display/legibility tweaks
    - Enlarge edge letters and node labels 1.5x for readability.
    - Remove the Vertices toggle and vertex circles; nodes now show as their
    v# label only (via the Node # toggle).
    - Color node labels green with a stroke halo so they stay legible over
    edges and faces in both themes.
    - Restyle the Reset button as a clearly-interactive blue action button
    (was permanently grey and read as disabled) — light + dark variants.
    - Lay the Faces list out in 2 columns.
    - Trim the Assembly Letters panel section to three bullet points and drop
    the per-letter vertex-pair list; the letters still render on the 3D
    edges and the runtime validation is unchange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
2026-07-13 Structure framework: color the f11 · Door face label pink
    Distinguish the Door face label from the other built faces (indigo) and
    the unbuilt bottom (orange).
    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
2026-07-13 Add full build work-instruction doc tree (Steps 1-2)
    Top-level index links to one Markdown file per build step; each step
    file holds its own numbered sub-steps plus a Safety/Release
    Gate/Open Items section, matching this repo's existing build/report
    doc style. Steps 1 (base platform) and 2 (structure set-up) are
    drafted from the author's outline; materials, dimensions, load
    ratings, and later steps (LED, controller box, coil, media/scent,
    finishing, commissioning) are flagged as open items rather than
    invented.
2026-07-13 Renumber marking-guide faces to match the 3D framework's f1-f12
    The two Face Edge Marking guides numbered the 11 built faces in their
    own order, and the 3D Structure Framework bridged the mismatch with a
    FACE_MAP lookup. Renumber the marking guides so face numbers agree
    across all three documents: Face 1 = f1 = Top, Face 11 = f11 = Door,
    and the 5 ground-edge faces become 7-11 (the faces bordering the
    unbuilt bottom f12). FACE_MAP is now the identity; it and the in-page
    validators are kept to guard against future drift.
    The physical assembly letters (A-Z, no W) are unchanged - every letter
    still joins the same two physical faces, only the face ids moved.
    Verified by data cross-check (25 joi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
2026-07-14 Group index.html links by document type
    The index generator in update-index.yml now sorts docs into three
    sections — Schematics, 3D Structure & LED Mapping, and Build & Assembly
    Guides — via ordered filename patterns, with an "Other Documents"
    fallback (hidden when empty) so future files always appear. Link text
    is the prettified filename (extension stripped, underscores → spaces).
    index.html is regenerated with the same script so the workflow's run
    on main is a no-op.
    Claude-Session: https://claude.ai/code/session_014MvPNeVQ94Y6QSBiVvKUVS
2026-07-14 Align build docs with the marking-guide face renumbering
    Main's 1b5c77a made marking-guide face numbers equal the framework's
    f-IDs (Face 1 = f1 = Top, Face 11 = f11 = Door, ground faces 7-11), so
    drop the old "Face 5 (f11)" style cross-notation and the stale
    "faces 1, 5, 6, 7, 8" ground-face list from Steps 1-2 and the index.
2026-07-14 Add project knowledge & history compendium (Rev 1.0)
    Compile everything known about NaoDec into one reference, capturing the
    material that is scattered, missing, or superseded:
    - Current per-subsystem snapshot (LED controller, 3D structure/mapping,
    series coil, media-playback, scent, power/box) with authoritative file
    pointers.
    - Information not in the repo: the referenced-but-absent
    XL4015 mockup procedure (with the recoverable outline), facts that live
    only in commit messages (bench 11.68 V/2.75 A, aroma->Scent rename, CCW
    edge-convention fix, the standalone Max tester), and the fact that the
    Pages auto-index lists only HTML so all Markdown knowledge is unpublished.
    - Supersed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
2026-07-14 Build work instructions: complete Steps 3-9 + decisions record
    Fills out the 9-step build sequence from the author's full outline and
    the recorded decisions (NaoDec_Build_Pending_Decisions.md):
    - Index -> Rev 1.1: 9-step table, mermaid build flow, Orientation
    Reference (occupant frame) and Terminology (Node 0 = controller unit,
    joint letters vs "Edge A-F"), sequence-level open items.
    - Step 2 -> Rev 1.1: fill 2.2 Panel Installation - 5 hinged pairs
    (joints M/O/R/T/U) + door, 2-hinges-per-lettered-edge rule, erection
    sequence lower -> upper -> ceiling, base landing map.
    - New Steps 3-9: vertex units (+ series-coil co-route), internal edge
    circuits C1-C6, speakers -> Wondom GAB8, mo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
2026-07-14 Add XL4015 CC/CV mockup test procedure (resolve dangling links)
    README referenced XL4015_CC_CV_Mockup_Test_Procedure.md in three places
    (repo tree + two Series Coil sections) but the file never existed. Create
    it from the values already documented in README's "XL4015 Mockup
    Qualification" section and the coil schematics: 1.86 Ohm mock load
    (1.30 Ohm mock wire + 0.56 Ohm/10 W resistor bank = 10x 5.6 Ohm/1 W),
    CV 11.0 +/-0.3 V, CC 3.0 +/-0.1 A, expected 5.58 V / 3.90 V / 1.68 V
    split, 30-min burn-in, and pass/fail gates. Distinguishes the mockup
    target from the bench-verified real-string point (11.68 V / 2.75 A at
    the CV/CC knee). Also links it directly from Step 9 sec 9.8.
2026-07-14 docs: add Play/Pause cross-trigger troubleshooting to build guide
    One button firing the other's transport command is a symmetric-short
    signature, not something the R3-R5/R8-R9 pull-up+debounce design can
    produce when healthy. Adds a Section 10 row that isolates the fault
    with a Max print test, then an unpowered GPIO9<->GPIO10 continuity
    check to tell a header/PCB bridge apart from a panel-side harness
    short or a firmware pin-map bug.
2026-07-14 firmware: enable internal pull-ups on encoder A/B (FW 3.1.1)
    Adopts the encpullup variant: GPIO7/8 now use INPUT_PULLUP instead of
    plain INPUT so the lines idle high even on a KY-040 clone missing its
    own onboard CLK/DT pull-ups. NEBDS-01 (push-pull Schmitt output) is
    unaffected. Scoped to the encoder only — Play/Pause/Stop (GPIO9-11)
    were already INPUT_PULLUP and are untouched, so this does not address
    the Play/Pause cross-trigger issue tracked separately.
    [media_playback_controller_R3.1.ino]
2026-07-14 fix: contain Play/Pause cross-trigger + correct Max Stop route
    The Play<->Pause cross-trigger is a hardware short between the adjacent
    GPIO9/GPIO10 header pins: both lines pull LOW together so one press reads
    as two. The audit cleared the other layers — firmware debounces each pin
    independently, and the Max test patch routes play/pause through separate
    OSC-route objects with no cross-wire — so no software change can cure a
    hard short (both pins read identically).
    - Firmware FW 3.1.2: treat the three transport buttons as mutually
    exclusive. Two press edges in the same debounce pass is physically
    impossible from a human on separate switches and is the short's
    signature, so reject th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
    [media_playback_controller_R3.1.ino]
2026-07-21 docs: complete Display Setup Requirements — power @ 1.25x current setup, 220V single-phase
    Adapt the department-store Display Setup Requirements template to the actual
    NaoDec build and work the power requirement at 1.25x the current setup from a
    220 V single-phase input, 10 hrs/day.
    Full connected-load inventory (AC mains draw per device):
    - Control box (audited): 329 W DC -> ~387 W AC
    - Mac mini ~65 W, monitor ~50 W, 2x 38 W fans (76 W), media controller ~12 W
    - Wondom GAB8 amp on Mean Well LRS-350-24 (24 V/350 W): ~120 W typ / ~400 W max
    - Edifier T5 active subwoofer: ~70 W typ / ~100 W peak
    - Chair PC-610 + table actuators: ~120 W each, intermittent (peak only)
    Result: current operati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
2026-07-21 docs: update Display Setup Requirements area to 4x5.5m, ceiling min 2.75m
    Set the total allocated floor area to 4 m x 5.5 m (22 m2) and the minimum
    ceiling clearance to 2.75 m across the physical/space, floor-plan, and
    structural sections (was a nominal 3x3 m / 9 m2 footprint, >=3 m ceiling).
    Distinguish the 22 m2 allocated area (structure + chair + operator station +
    egress) from the structure's ground-contact footprint used for the floor-load
    check. Flag that the nominal ~3 m dodecahedron must be confirmed to fit under
    the 2.75 m ceiling (no exact assembled height in the repo) as a confirm-on-site
    item. No electrical figures changed. Bump doc to v1.1.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
2026-07-22 docs: add router to the electrical load inventory (~12 W)
    The ASUS RT-AX1800HP router lives in the controller unit (wired LAN to the
    Mac mini and the chair's W5500 module) but was missing from the connected-
    load inventory. Add it as item H (~12 W typical / ~18 W adapter max) and
    propagate through every downstream figure:
    - Continuous operating load: ~780 W -> ~792 W
    - 1.25x design requirement: ~975 W -> ~990 W (still ~1.0 kW)
    - Worst-case transient: ~1.36 kW -> ~1.37 kW
    - Current @ 220V: ~4.9 A -> ~5.0 A (1.25x target)
    - Daily energy: ~7.8 kWh/day -> ~7.9 kWh/day
    Also cite NaoDec_Build_Step8_Controller_Unit_Hookup.md's own open item
    ("no single mains/CB plan exists") as repo-side corrobor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
2026-07-22 docs: real structure dims/weight; datasheet check on GAB8/T5; finalize actuator estimates
    Update the requirements doc with user-confirmed physical facts:
    - Structure is 3 m x 3 m x 2.5 m (W x L x H), not a 3 m cube -- resolves the
    previously-flagged ceiling-fit item: 2.5 m fits under the 2.75 m minimum
    clearance with ~0.25 m margin.
    - Total structure-zone weight is ~290 kg over the 9 m2 footprint (~32 kg/m2,
    well within typical retail floor ratings). The operator, table, controller
    unit, Mac mini, and monitor sit outside the 3x3 m structure footprint, in
    the remaining allocated area -- a separate, lighter load zone.
    - Stability certification note reworded: structure height sits exa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
2026-07-22 docs: add move-in logistics questions + component load-in schedule
    None of the move-in/logistics questions (setup time window, overnight
    option, drop-off gate location/distance, floor protection, trolley
    availability, elevator sizing) were in the document before. Add them to
    Section 1's Access & Operations checklist, plus a new Move-In Component
    Schedule table using the user-provided piece dimensions:
    - 11x pentagon panel: 1.69 x 1.61 x 0.03 m
    - Chair platform (pentagon): 1.91 x 1.82 m, 0.23 m platform height
    - Structure platform: 1x door step (18 kg) + 4x side (6.2 kg each)
    - Chair + table (dimensions/weight not yet provided)
    - Pallet: 1.1 x 1.1 x 0.16 m
    Flag the chair platform (1.91 x 1.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
2026-07-22 docs: fill in component weights; reconcile against the ~290 kg total
    Fill the remaining TBDs in the Move-In Component Schedule with user-provided
    weights/dimensions: panels ~6 kg each, chair platform ~50 kg, pallet ~5 kg,
    chair 1.09 x 0.79 x 1.19 m (extends to 1.60 m) ~30 kg, table 0.6 x 1.2 x 0.8 m
    ~15 kg.
    Reframe the elevator/trolley concern: no single item is a weight problem
    (heaviest carry ~50 kg), so size -- not load capacity -- is the real
    constraint (chair platform's 1.91 x 1.82 m footprint).
    Add a weight reconciliation in §4: known structure-zone hardware (~194 kg)
    plus an assumed occupant (~75 kg) and the Edifier T5's published weight
    (~8.6 kg) sums to ~278 kg, consistent with t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
2026-07-22 docs: use rated max occupant weight (100 kg) as the structural design basis
    Replace the average-adult occupant assumption (~75 kg) used in the §4 weight
    reconciliation with the user-specified rated maximum of 100 kg per occupant --
    the correct basis for structural/floor-load design, versus a typical-case
    estimate.
    Recompute the structure-zone design total: known hardware (~194 kg) + max
    occupant (100 kg) + Edifier T5 subwoofer (~8.6 kg) = ~302 kg, rounded to
    ~305 kg for margin -- about 12 kg above the originally-stated ~290 kg, with
    the difference explained as the average-to-maximum occupant switch. Floor
    loading recalculates to ~34 kg/m² (was ~32 kg/m²), still comfortably within
    typical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
2026-07-22 docs: itemize LED/edge-cover/vertex/speaker weight; correct chair to 40 kg
    Add the previously-unitemized structure hardware to the §4 weight
    reconciliation, per user figures:
    - LED tubes: 30 x 100 g = 3 kg
    - Edge covers: 30 x 200 g = 6 kg
    - Vertex units: 20 x 400 g = 8 kg
    - Speakers w/ mounts: 6 x 1000 g = 6 kg
    - Subtotal 23 kg, rounded to ~30 kg (incl. wiring/cable allowance)
    Also correct the chair (PC-610) weight from ~30 kg to the user-confirmed
    40 kg, in both the §1 Move-In Component Schedule and the §4 reconciliation.
    Recompute the structural design total: known hardware (~204 kg, incl. the
    corrected chair) + LEDs/covers/vertex/speakers (~30 kg) + occupant (100 kg
    rated max) + subw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
2026-07-22 docs: add internal team notes for the Display Setup Requirements
    Add NaoDec_Display_Setup_Notes.md, a companion document to
    NaoDec_Display_Setup_Requirements.md aimed at the team rather than the
    store: full derivation of the power/weight/logistics figures, the
    reasoning and sources behind each, and a revision history for the
    structural weight (290 -> 305 -> 345 kg) so the changing numbers across
    this project's history make sense to anyone picking it up.
    Add a README documents-table row for the new file.
    Claude-Session: https://claude.ai/code/session_01NEVy9E7hm46o8m5TGRdH5U
2026-07-22 docs: add HTML rendering of the Display Setup Notes
    Add a static, self-contained HTML version of NaoDec_Display_Setup_Notes.md
    for easy team viewing/printing alongside the existing Markdown copy.
    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
